tomstraka01-git/DYI-LORA/screenshots/JOURNAL6-IMG17.png

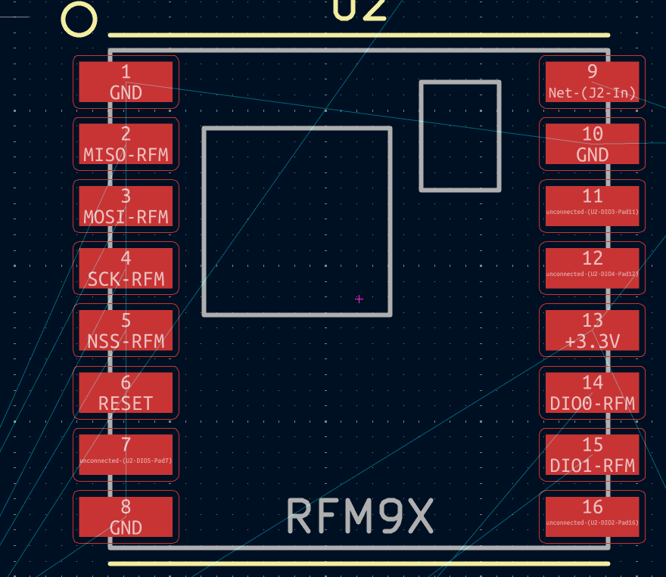
screenshots/JOURNAL6-IMG17.png
