tomstraka01-git/DYI-LORA/DYI-LORA-PCB/DYI-LORA-PCB.kicad_pcb

## KiCad design DYI-LORA-PCB/DYI-LORA-PCB.kicad_pcb (2026-07-18)

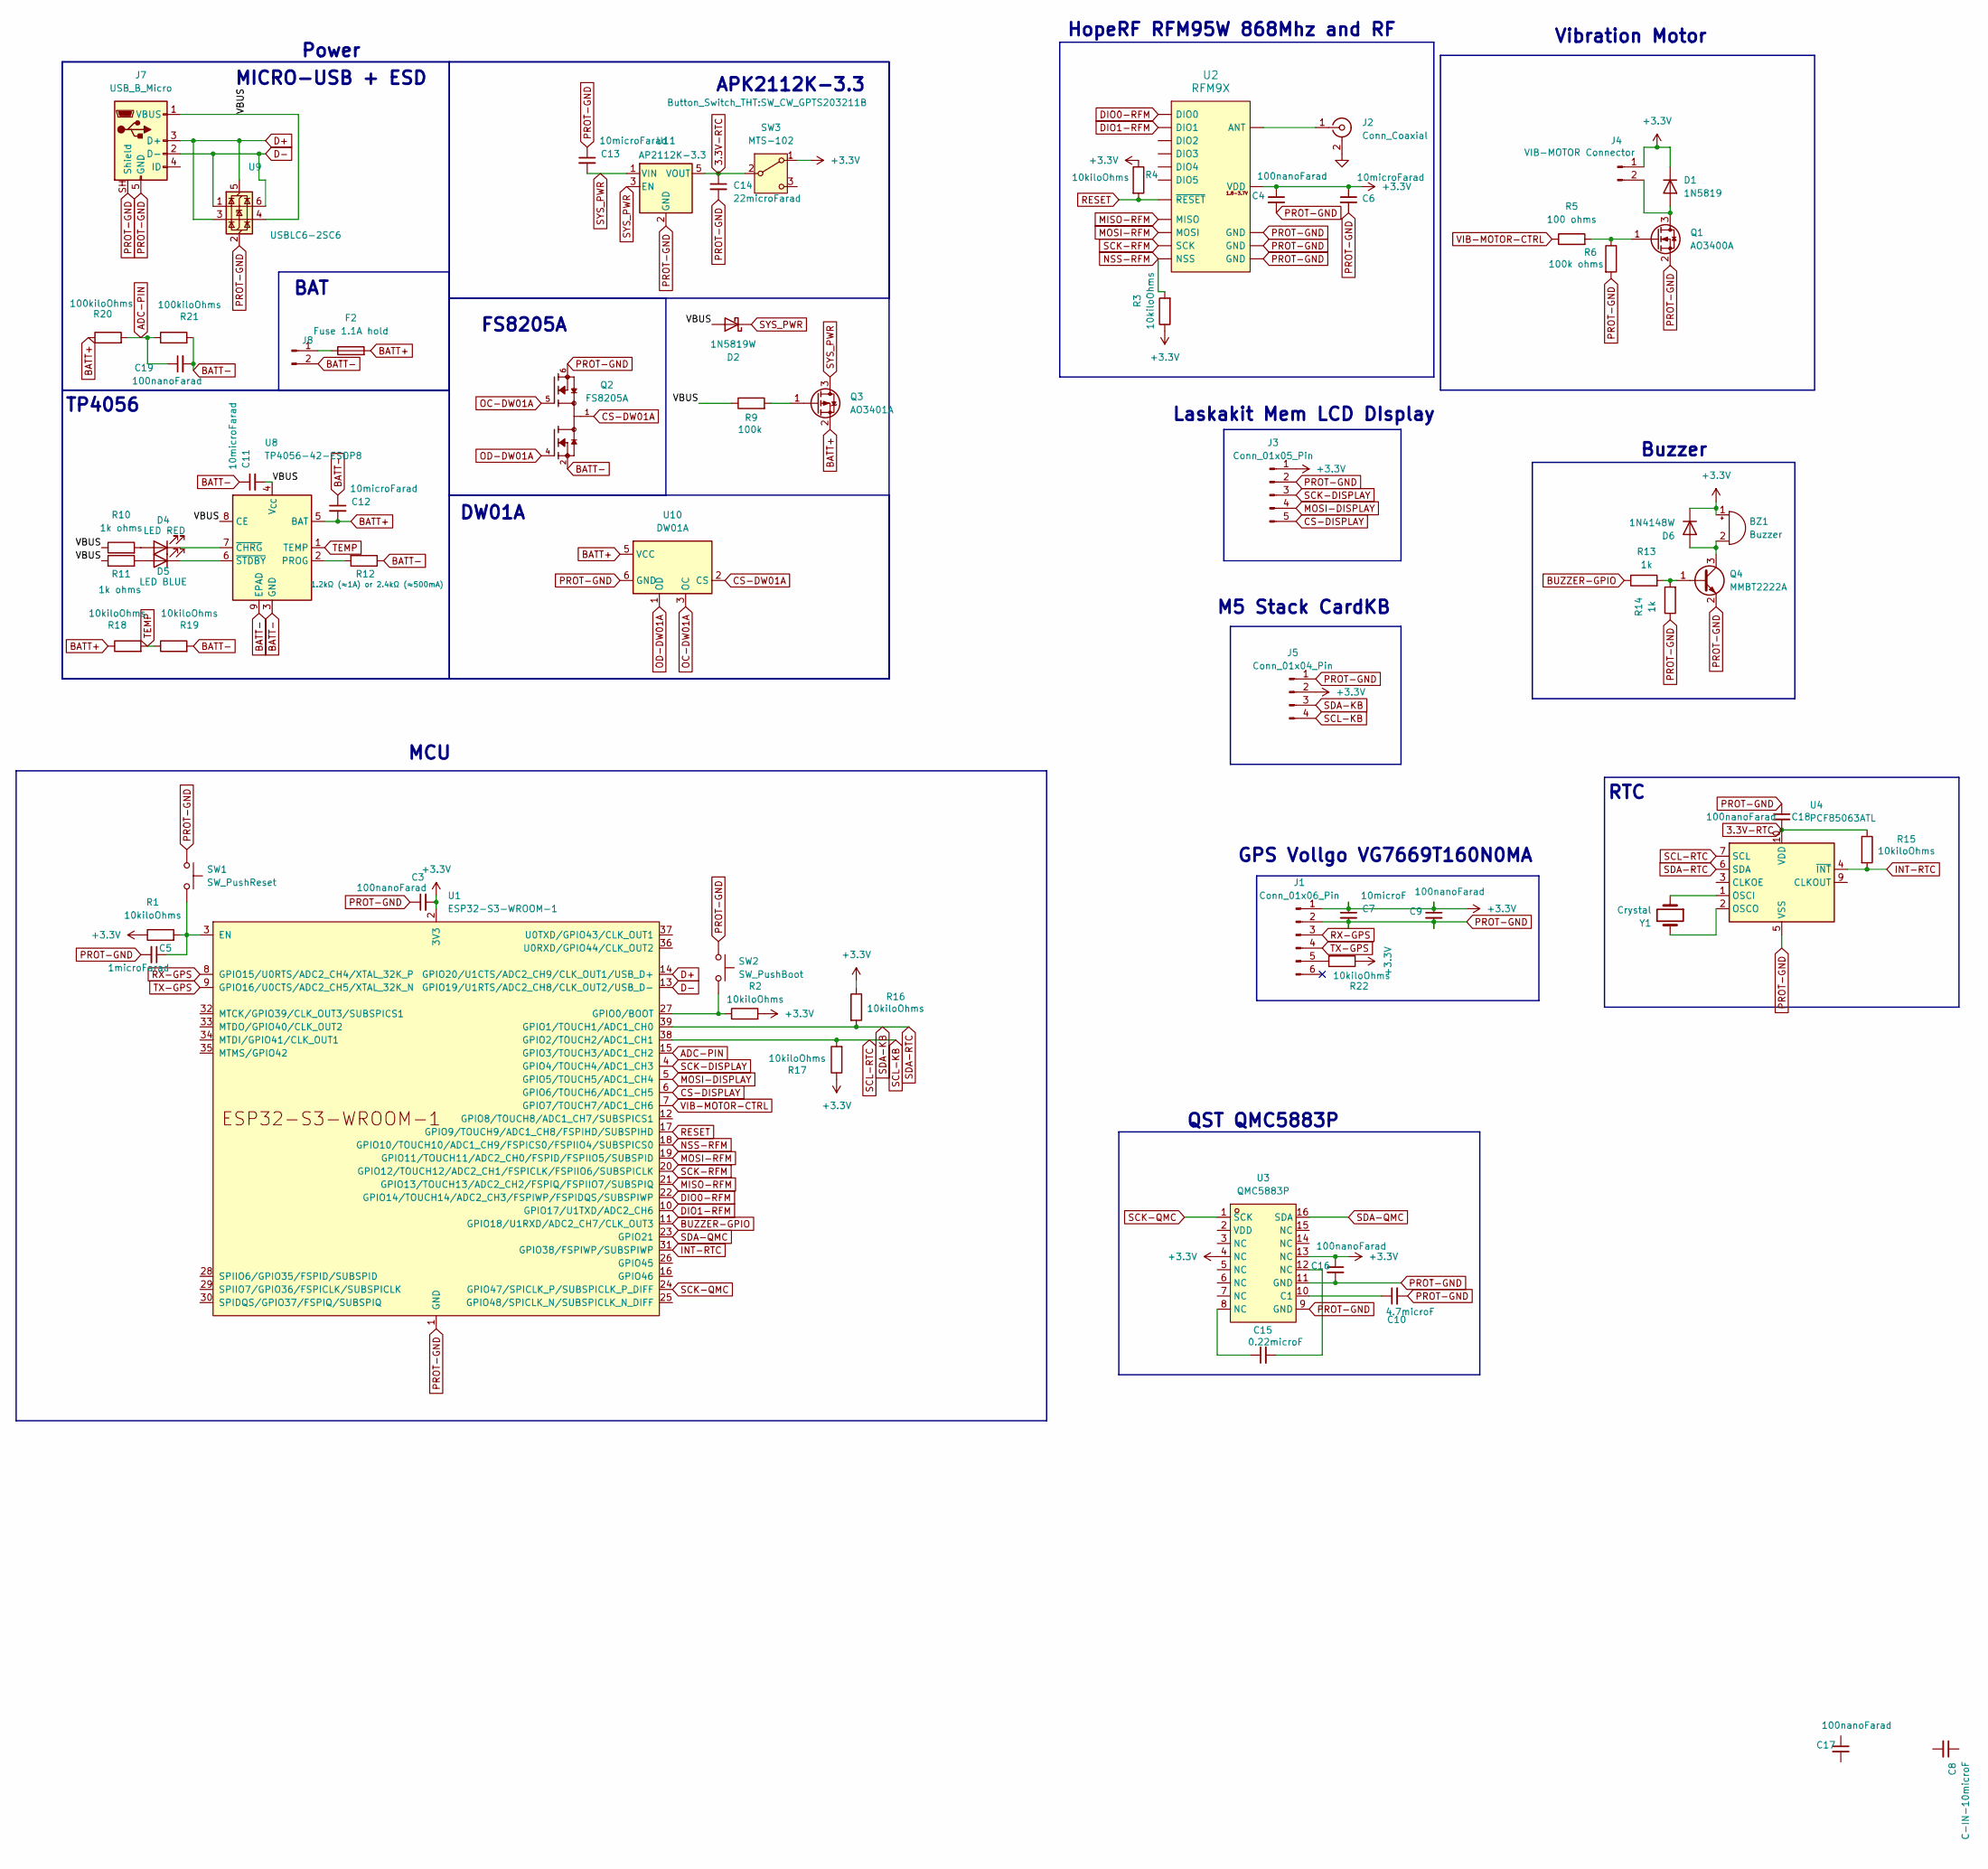
[picture p72: schematic DYI-LORA-PCB.kicad_sch]

Parts:
BZ1: Buzzer; MagneticBuzzer_PUI_AT-0927-TT-6-R
C3, C4, C9, C16, C17, C18, C19: 100nanoFarad; C_0603_1608Metric_Pad1.08x0.95mm_HandSolder
C5: 1microFarad; C_1206_3216Metric_Pad1.33x1.80mm_HandSolder
C6, C11, C12, C13: 10microFarad; C_0805_2012Metric_Pad1.18x1.45mm_HandSolder
C7: 10microF; C_0805_2012Metric_Pad1.18x1.45mm_HandSolder
C8: C-IN-10microF; C_0805_2012Metric_Pad1.18x1.45mm_HandSolder
C10: 4.7microF; C_0805_2012Metric_Pad1.18x1.45mm_HandSolder
C14: 22microFarad; C_1206_3216Metric_Pad1.33x1.80mm_HandSolder
C15: 0.22microF; C_0805_2012Metri
D1: 1N5819; D_SOD-123
D2: 1N5819W; D_SOD-123
D4: LED RED; LED_0805_2012Metric_Pad1.15x1.40mm_HandSolder
D5: LED BLUE; LED_0805_2012Metric_Pad1.15x1.40mm_HandSolder
D6: 1N4148W; D_SOD-123
F2: Fuse 1.1A hold; Fuse_1206_3216Metric_Pad1.42x1.75mm_HandSolder
J1: Conn_01x06_Pin; JST_SH_SM06B-SRSS-TB_1x06-1MP_P1.00mm_Horizontal
J2: Conn_Coaxial; SMA_Amphenol_132134-11_Vertical
J3: Conn_01x05_Pin; PinHeader_1x05_P2.54mm_Vertical
J4: VIB-MOTOR Connector; PinHeader_1x02_P2.54mm_Vertical
J5: Conn_01x04_Pin; JST_SH_SM04B-SRSS-TB_1x04-1MP_P1.00mm_Horizontal
J7: USB_B_Micro; USB_Micro-B_Molex_47346-0001
J8: Conn_01x02_Pin; JST_PH_S2B-PH-K_1x02_P2.00mm_Horizontal
Q1: AO3400A; SOT-23_Handsoldering
Q2: FS8205A; TSSOP-8_4.4x3mm_P0.65mm; PARTREV 1.7
Q3: AO3401A; SOT-23_Handsoldering
Q4: MMBT2222A; SOT-23_Handsoldering
R1, R2, R3, R4, R15, R16, R17, R18, R19, R22: 10kiloOhms; R_1206_3216Metric_Pad1.30x1.75mm_HandSolder
R5: 100 ohms; R_1206_3216Metric_Pad1.30x1.75mm_HandSolder
R6: 100k ohms; R_1206_3216Metric_Pad1.30x1.75mm_HandSolder
R9: 100k; R_0805_2012Metric_Pad1.20x1.40mm_HandSolder
R10, R11: 1k ohms; R_1206_3216Metric_Pad1.30x1.75mm_HandSolder
R12: 1.2kΩ (≈1A) or 2.4kΩ (≈500mA); R_1206_3216Metric_Pad1.30x1.75mm_HandSolder
R13, R14: 1k; R_0805_2012Metric_Pad1.20x1.40mm_HandSolder
R20, R21: 100kiloOhms; R_1206_3216Metric_Pad1.30x1.75mm_HandSolder
SW1: SW_PushReset; SW_PUSH_6mm_H4.3mm
SW2: SW_PushBoot; SW_PUSH_6mm_H4.3mm
SW3: MTS-102; SW_CW_GPTS203211B
U1: ESP32-S3-WROOM-1
U2: RFM9X; RFM9X-SMD
U3: QMC5883P; LGA-16_3x3mm_P0.5mm; MPN QMC5883P; LCSC Part C2847467
U4: PCF85063ATL; DFN-10-1EP_2.6x2.6mm_P0.5mm_EP1.3x2.2mm
U8: TP4056-42-ESOP8; SOIC-8-1EP_3.9x4.9mm_P1.27mm_EP2.41x3.3mm_ThermalVias
U9: USBLC6-2SC6; SOT-23-6
U10: DW01A; SOT-23-6
U11: AP2112K-3.3; SOT-23-5_HandSoldering
Y1: Crystal; Crystal_SMD_3215-2Pin_3.2x1.5mm

Connections:
3.3V-RTC: C14.1, C18.2, R15.1, SW3.2 (B), U4.10 (VDD), U11.5 (VOUT)
+3.3V: BZ1.1 (+), C3.2, C4.1, C6.1, C7.1, C9.1, C16.1, D1.1 (K), D6.1 (K), J1.1, J3.1, J4.1, J5.2, R1.1, R2.2, R3.1, R4.1, R16.1, R17.1, R22.1, SW3.1 (A), U1.2 (3V3), U2.13 (VDD), U3.4 (NC), U3.13 (NC)
/VBUS: C11.2, D2.2 (A), J7.1 (VBUS), R9.1, R10.1, R11.1, U8.4 (V_{CC}), U8.8 (CE), U9.4 (I/O2)
ADC-PIN: C19.1, R20.2, R21.1, U1.15 (GPIO3/TOUCH3/ADC1_CH2)
BATT+: C12.2, F2.2, Q3.2 (S), R18.1, R20.1, U8.5 (BAT), U10.5 (VCC)
BATT-: C11.1, C12.1, C19.2, J8.2, Q2.2, Q2.3, R12.1, R19.2, R21.2, U8.3 (GND), U8.9 (EPAD)
BUZZER-GPIO: R13.1, U1.11 (GPIO18/U1RXD/ADC2_CH7/CLK_OUT3)
CS-DISPLAY: J3.5, U1.6 (GPIO6/TOUCH6/ADC1_CH5)
CS-DW01A: Q2.1, Q2.8, U10.2 (CS)
D+: J7.3 (D+), U1.14 (GPIO20/U1CTS/ADC2_CH9/CLK_OUT1/USB_D+), U9.3 (I/O2), U9.5 (VBUS)
D-: J7.2 (D-), U1.13 (GPIO19/U1RTS/ADC2_CH8/CLK_OUT2/USB_D-), U9.1 (I/O1), U9.6 (I/O1)
DIO0-RFM: U1.22 (GPIO14/TOUCH14/ADC2_CH3/FSPIWP/FSPIDQS/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), U2.14 (DIO0)
DIO1-RFM: U1.10 (GPIO17/U1TXD/ADC2_CH6), U2.15 (DIO1)
GND: J2.2 (Ext)
INT-RTC: R15.2, U1.31 (GPIO38/FSPIWP/SUBSPIWP), U4.4 (~INT)
MISO-RFM: U1.21 (GPIO13/TOUCH13/ADC2_CH2/FSPIQ/FSPIIO7/S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), U2.2 (MISO)
MOSI-DISPLAY: J3.4, U1.5 (GPIO5/TOUCH5/ADC1_CH4)
MOSI-RFM: U1.19 (GPIO11/TOUCH11/ADC2_CH0/FSPID/FSPIIO5/S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), U2.3 (MOSI)
NSS-RFM: R3.2, U1.18 (GPIO10/TOUCH10/ADC1_CH9/FSPICS0/FSPIIO4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), U2.5 (NSS)
unnamed: BZ1.2 (-), D6.2 (A), Q4.3 (C)
unnamed: C15.1, U3.8 (NC)
unnamed: C15.2, U3.12 (NC)
unnamed: D1.2 (A), J4.2, Q1.3 (D)
unnamed: D4.2 (A), R10.2
unnamed: D4.1 (K), U8.7 (~CHRG)
unnamed: D5.2 (A), R11.2
unnamed: D5.1 (K), U8.6 (~STDBY)
unnamed: J1.5, R22.2
unnamed: J2.1 (In), U2.9 (ANT)
unnamed: F2.1, J8.1
unnamed: Q1.1 (G), R5.2, R6.1
unnamed: Q3.1 (G), R9.2
unnamed: Q4.1 (B), R13.2, R14.2
unnamed: C5.1, R1.2, SW1.2, U1.3 (EN)
unnamed: R2.1, SW2.2, U1.27 (GPIO0/BOOT)
unnamed: C10.1, U3.10 (C1)
unnamed: U4.1 (OSCI), Y1.1
unnamed: U4.2 (OSCO), Y1.2
unnamed: R12.2, U8.2 (PROG)
OC-DW01A: Q2.5, U10.3 (OC)
OD-DW01A: Q2.4, U10.1 (OD)
PROT-GND: C3.1, C4.2, C5.2, C6.2, C7.2, C9.2, C10.2, C13.1, C14.2, C16.2, C18.1, J1.2, J3.2, J5.1, J7.5 (GND), J7.SH (Shield), Q1.2 (S), Q2.6, Q2.7, Q4.2 (E), R6.2, R14.1, SW1.1, SW2.1, U1.1 (GND), U1.40 (GND), U1.41 (GND), U2.1 (GND), U2.8 (GND), U2.10 (GND), U3.9 (GND), U3.11 (GND), U4.5 (VSS), U9.2 (GND), U10.6 (GND), U11.2 (GND)
RESET: R4.2, U1.17 (GPIO9/TOUCH9/ADC1_CH8/FSPIHD/SUBSPIHD), U2.6 (~RESET)
RX-GPS: J1.3, U1.8 (GPIO15/U0RTS/ADC2_CH4/XTAL_32K_P)
SCK-DISPLAY: J3.3, U1.4 (GPIO4/TOUCH4/ADC1_CH3)
SCK-QMC: U1.24 (GPIO47/SPICLK_P/SUBSPICLK_P_DIFF), U3.1 (SCK)
SCK-RFM: U1.20 (GPIO12/TOUCH12/ADC2_CH1/FSPICLK/FSPIIO6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), U2.4 (SCK)
SCL-KB: J5.4, R17.2, U1.38 (GPIO2/TOUCH2/ADC1_CH1), U4.7 (SCL)
SDA-KB: J5.3, R16.2, U1.39 (GPIO1/TOUCH1/ADC1_CH0), U4.6 (SDA)
SDA-QMC: U1.23 (GPIO21), U3.16 (SDA)
SYS_PWR: C13.2, D2.1 (K), Q3.3 (D), U11.1 (VIN), U11.3 (EN)
TEMP: R18.2, R19.1, U8.1 (TEMP)
TX-GPS: J1.4, U1.9 (GPIO16/U0CTS/ADC2_CH5/XTAL_32K_N)
VIB-MOTOR-CTRL: R5.1, U1.7 (GPIO7/TOUCH7/ADC1_CH6)

Notes on the sheet:
RTC
TP4056
Vibration Motor
MCU
Buzzer
Power
GPS Vollgo VG7669T160N0MA
MICRO-USB + ESD
Laskakit Mem LCD DIsplay
APK2112K-3.3
HopeRF RFM95W 868Mhz and RF
QST QMC5883P
DW01A
M5 Stack CardKB
FS8205A
BAT

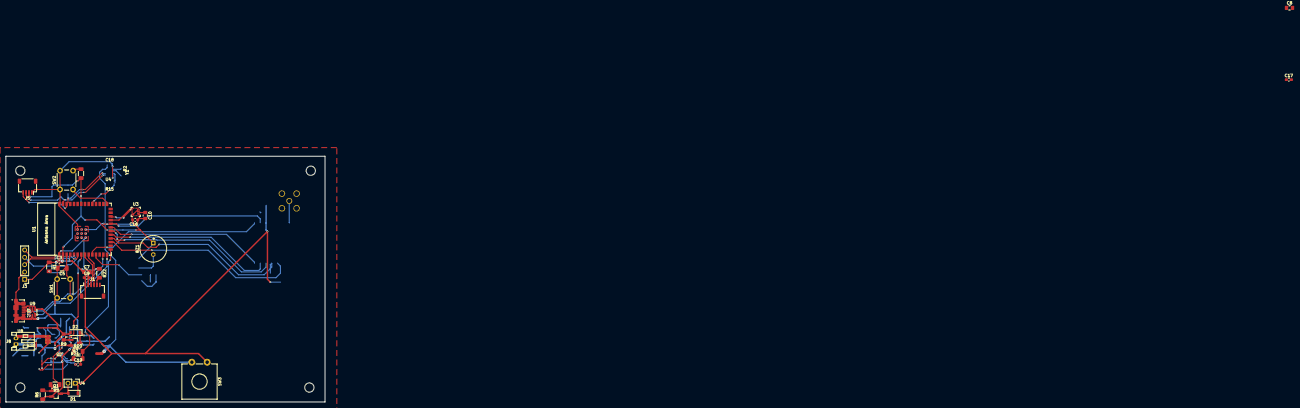
[picture p73: board DYI-LORA-PCB.kicad_pcb from above]

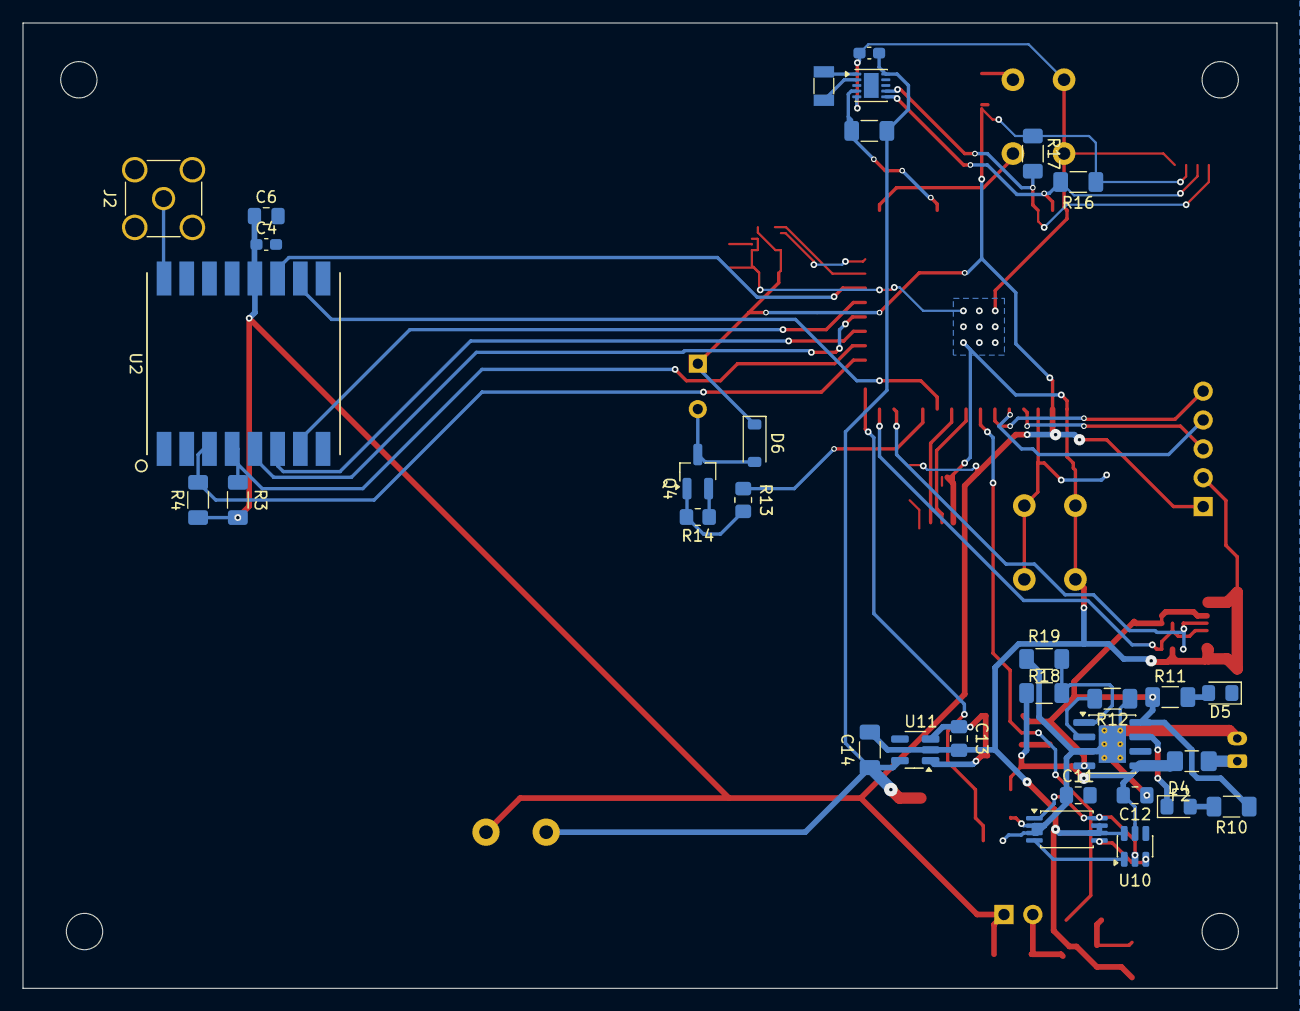
[picture p74: board DYI-LORA-PCB.kicad_pcb from below]

Board: 2 copper layers, 110.4 x 85.0 mm, 66 parts (32 on the bottom side), 51 nets.
