tomstraka01-git/DYI-LORA/(commit log)

2026-07-13 Journal 2
    [DYI-LORA-PCB.kicad_pcb, DYI-LORA-PCB.kicad_sch]
2026-07-15 journal 3
    [DYI-LORA-PCB.kicad_sch]
2026-07-15 Successfully ignore KiCad lock files
2026-07-16 journal 4
    [DYI-LORA-PCB.kicad_sch]
2026-07-17 journal 5 and 6
    [DYI-LORA-PCB.kicad_pcb, DYI-LORA-PCB.kicad_sch]
2026-07-18 journal 7
    [DYI-LORA-PCB.kicad_pcb, DYI-LORA-PCB.kicad_sch]
